billabongAFS/windlogger_shield/README.md

# widlogger_shield
This is the branch for the current version : v2.0.1

This board contains the functions to convert the signals from sensors to signals for the microcontroller.

This board is design to be plug in the digital board, but you can use it with an arduino uno or mega.

Comment are insert in the schematic, open the kicad project or the pdf export to read those.

## BLOCK DIAGRAM
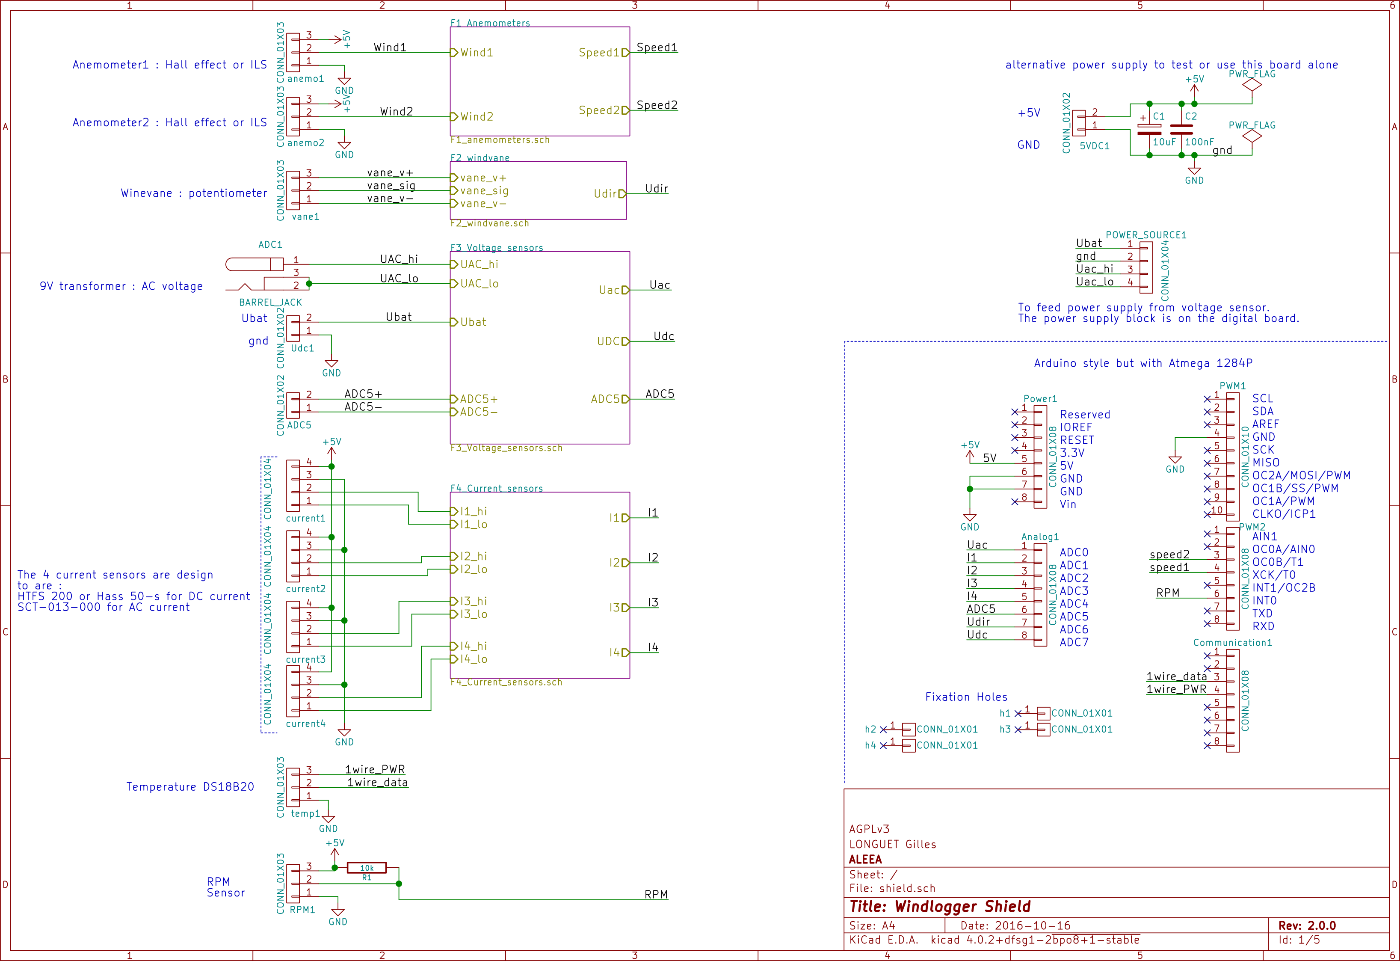
[picture p1: shield_bd.png]
windlogger shield block diagram


## RENDER PREVIEW
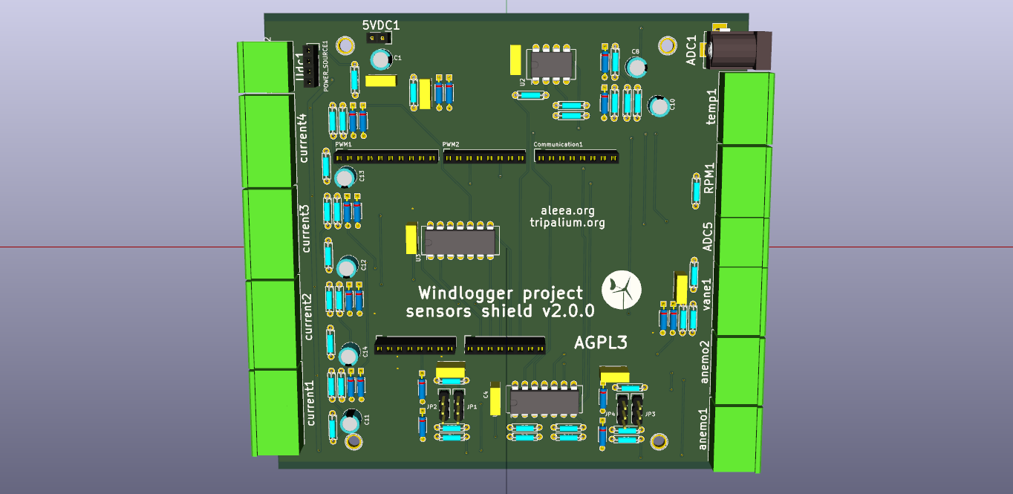
[picture p2: shield_pcb.png]
windlogger shield render preview


## Todo list
- chose the componants
- update the BOM
- route the board
- test
