billabongAFS/windlogger_shield/PDF/shield.pdf

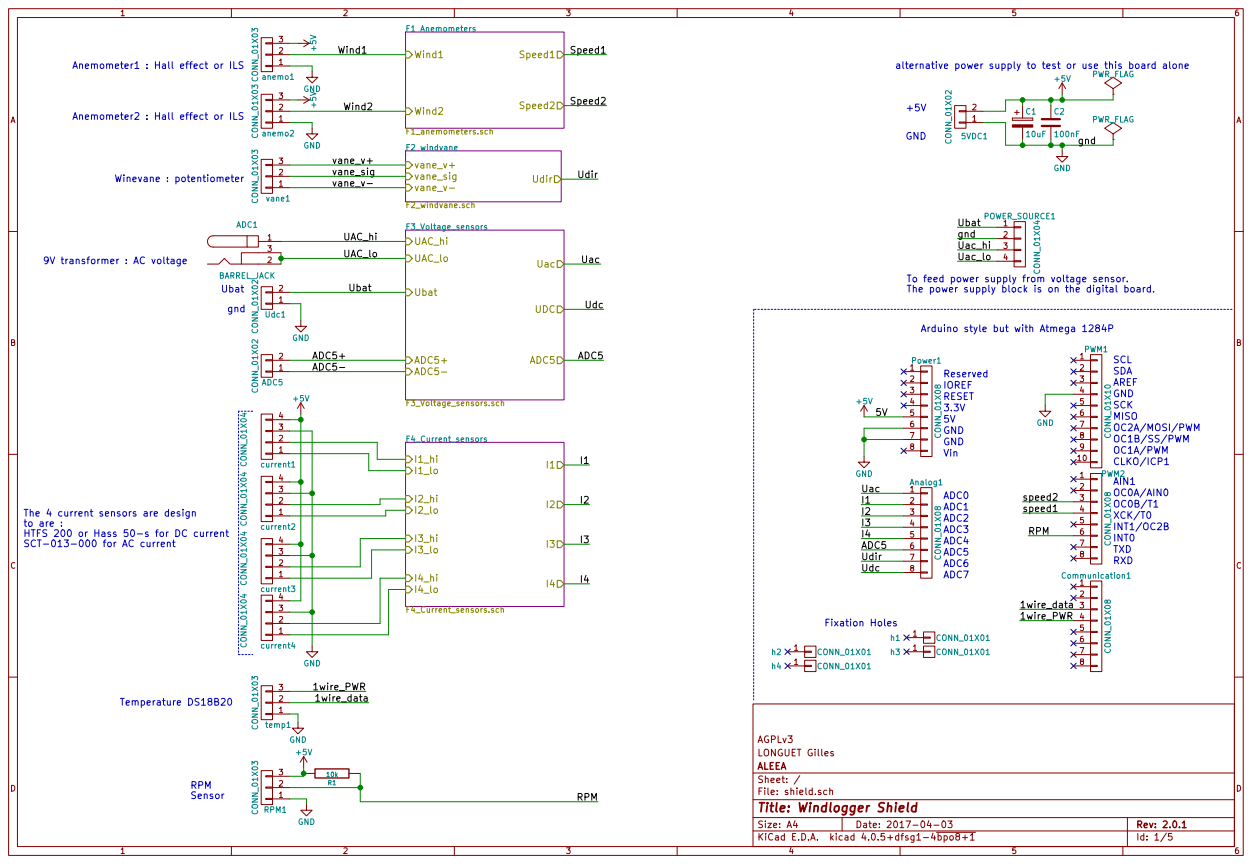
[picture p13: page 1]

Anemometer1 : Hall effect or ILS

vane_v- vane_v+ Anemometer2 : Hall effect or ILS

To feed power supply from voltage sensor.
The power supply block is on the digital board.

Vin Reserved Arduino style but with Atmega 1284P

+5V The 4 current sensors are design

to are : HTFS 200 or Hass 50-s for DC current

1wire_data

LONGUET Gilles AGPLv3

File: shield.sch Sheet: / ALEEA

Id: 1/5 Title: Windlogger Shield

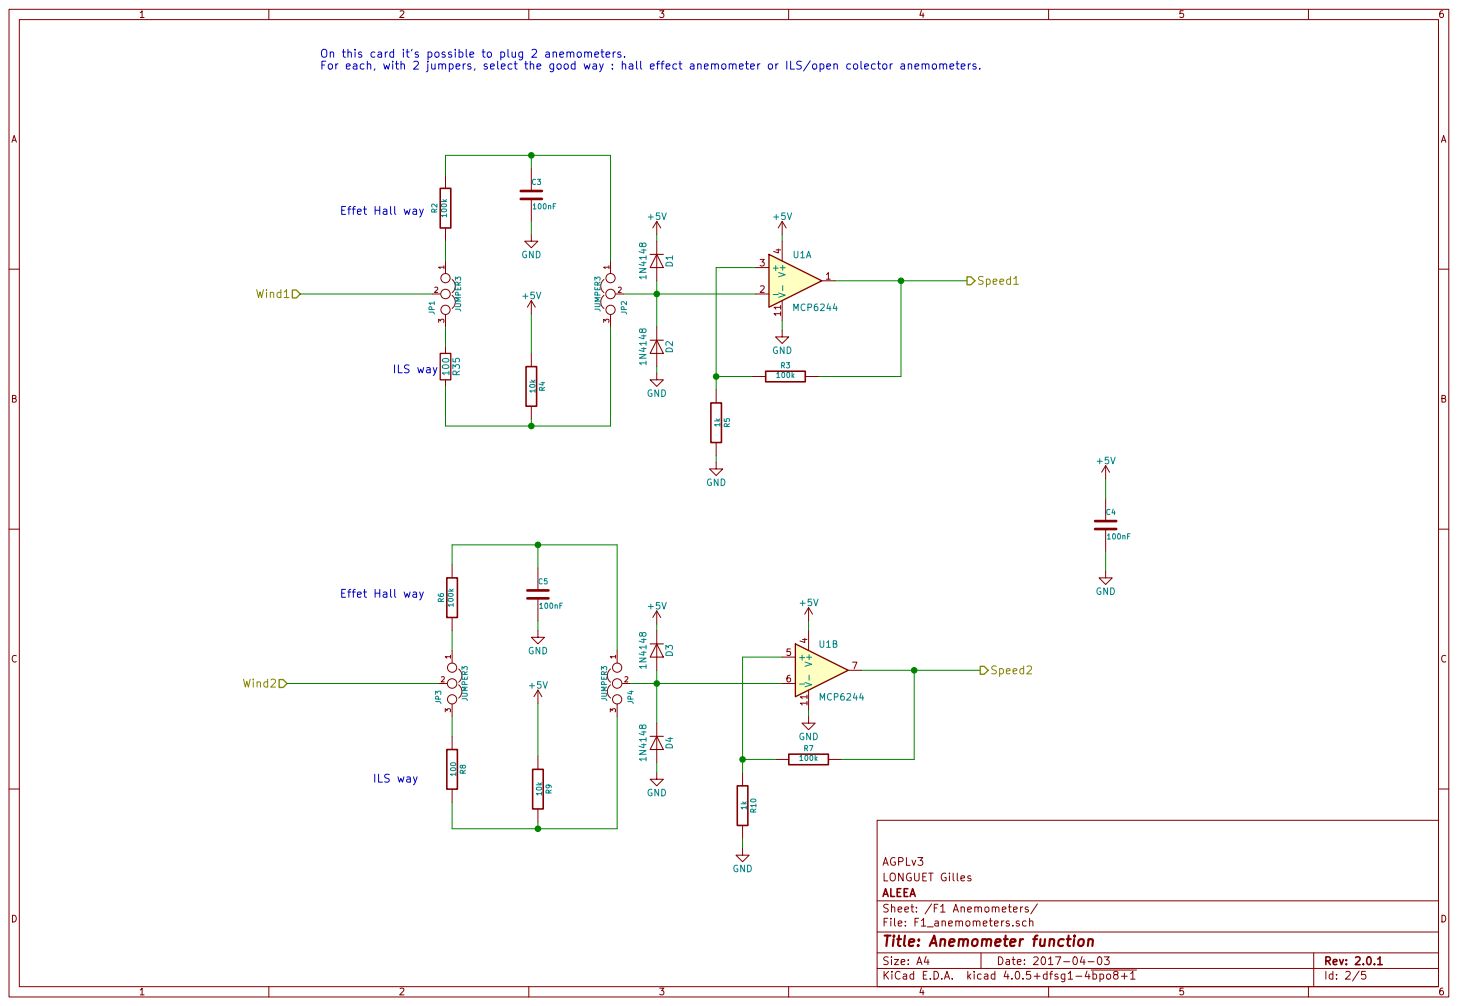
[picture p14: page 2]

On this card it's possible to plug 2 anemometers.

File: F1_anemometers.sch Sheet: /F1 Anemometers/ ALEEA

Id: 2/5 Title: Anemometer function

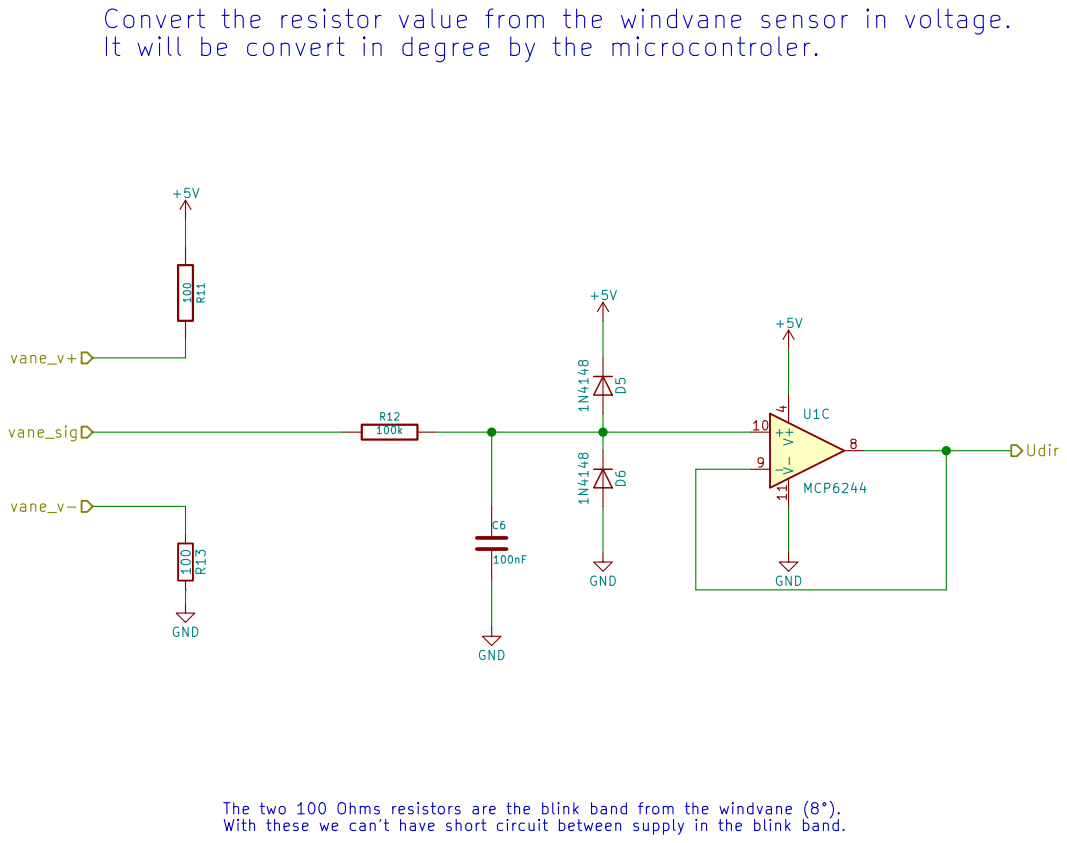
[picture p15: page 3]

Convert the resistor value from the windvane sensor in voltage.
It will be convert in degree by the microcontroler.

The two 100 Ohms resistors are the blink band from the windvane (8°).

File: F2_windvane.sch Sheet: /F2 windvane/ ALEEA

Id: 3/5 Title: Windvane function

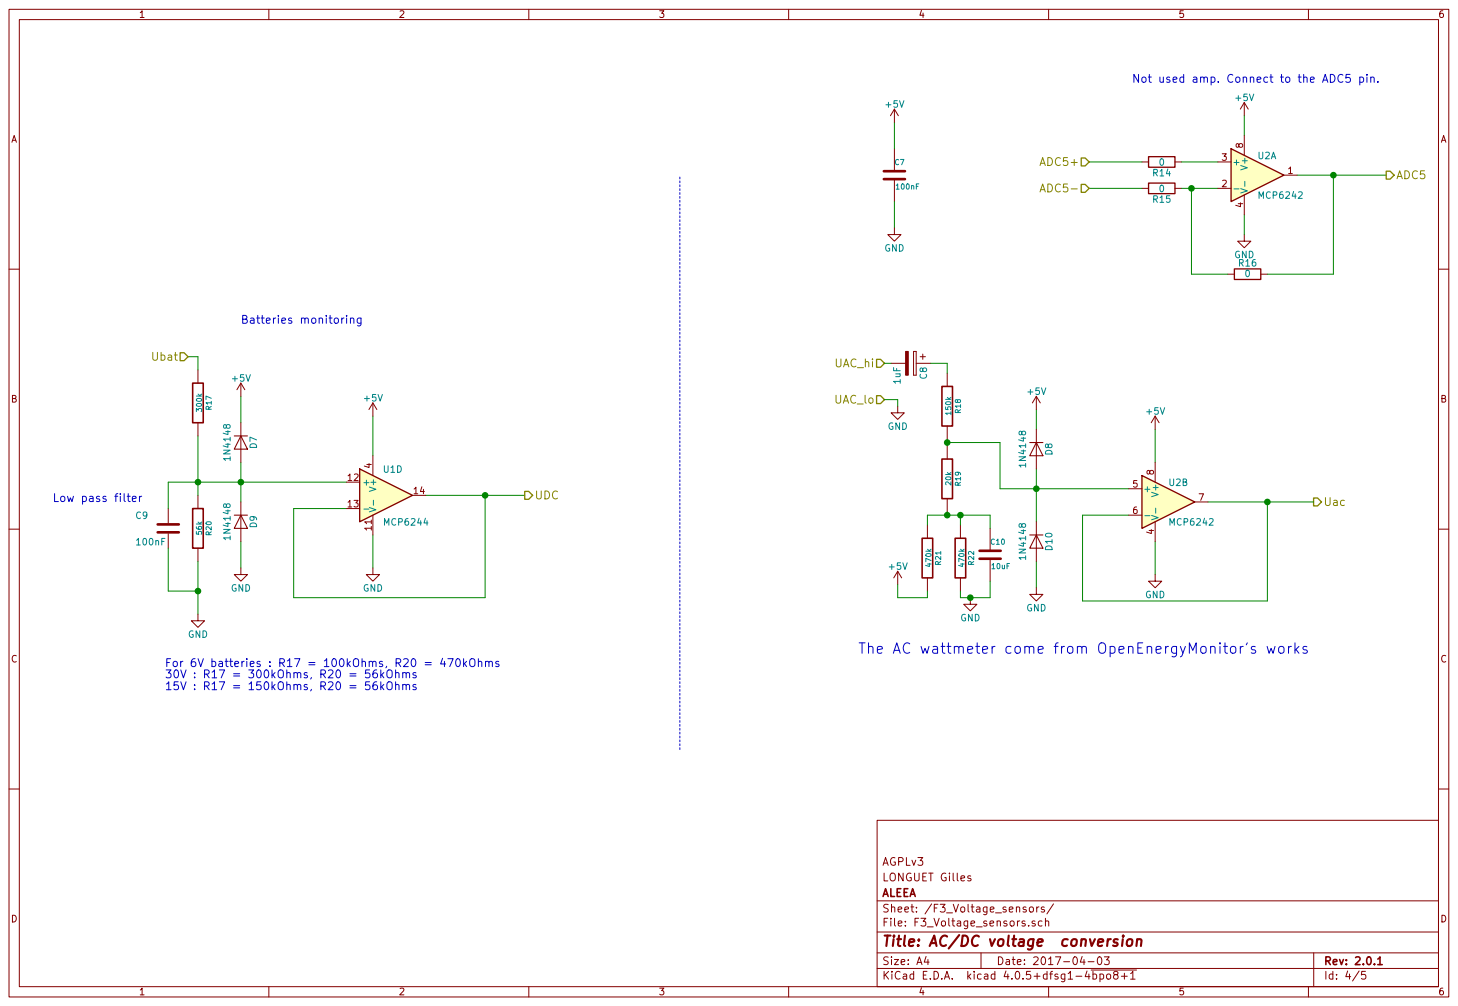
[picture p16: page 4]

Not used amp. Connect to the ADC5 pin.

100nF The AC wattmeter come from OpenEnergyMonitor's works 150k R18 +5V

File: F3_Voltage_sensors.sch
Id: 4/5 Title: AC/DC voltage conversion

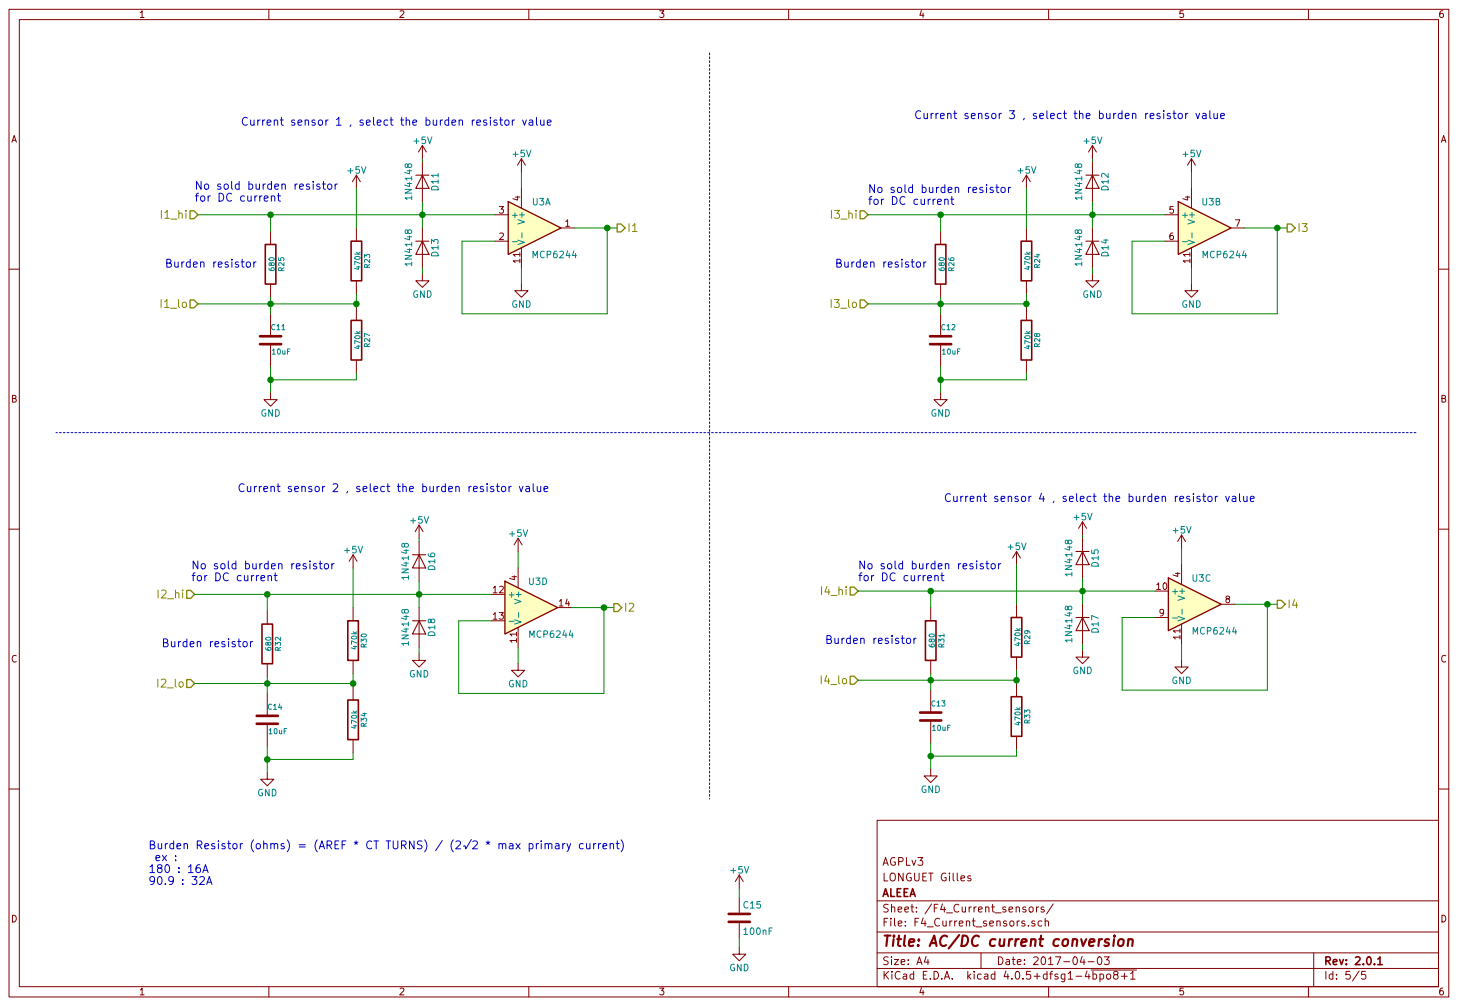
[picture p17: page 5]

for DC current No sold burden resistor

No sold burden resistor
for DC current

Current sensor 2 , select the burden resistor value

Current sensor 4 , select the burden resistor value

Burden Resistor (ohms) = (AREF * CT TURNS) / (22 * max primary current)

File: F4_Current_sensors.sch
Id: 5/5 Title: AC/DC current conversion
