billabongAFS/windlogger_shield/kicad/F1_anemometers.sch

## KiCad design kicad/F1_anemometers.sch (2018-02-20)

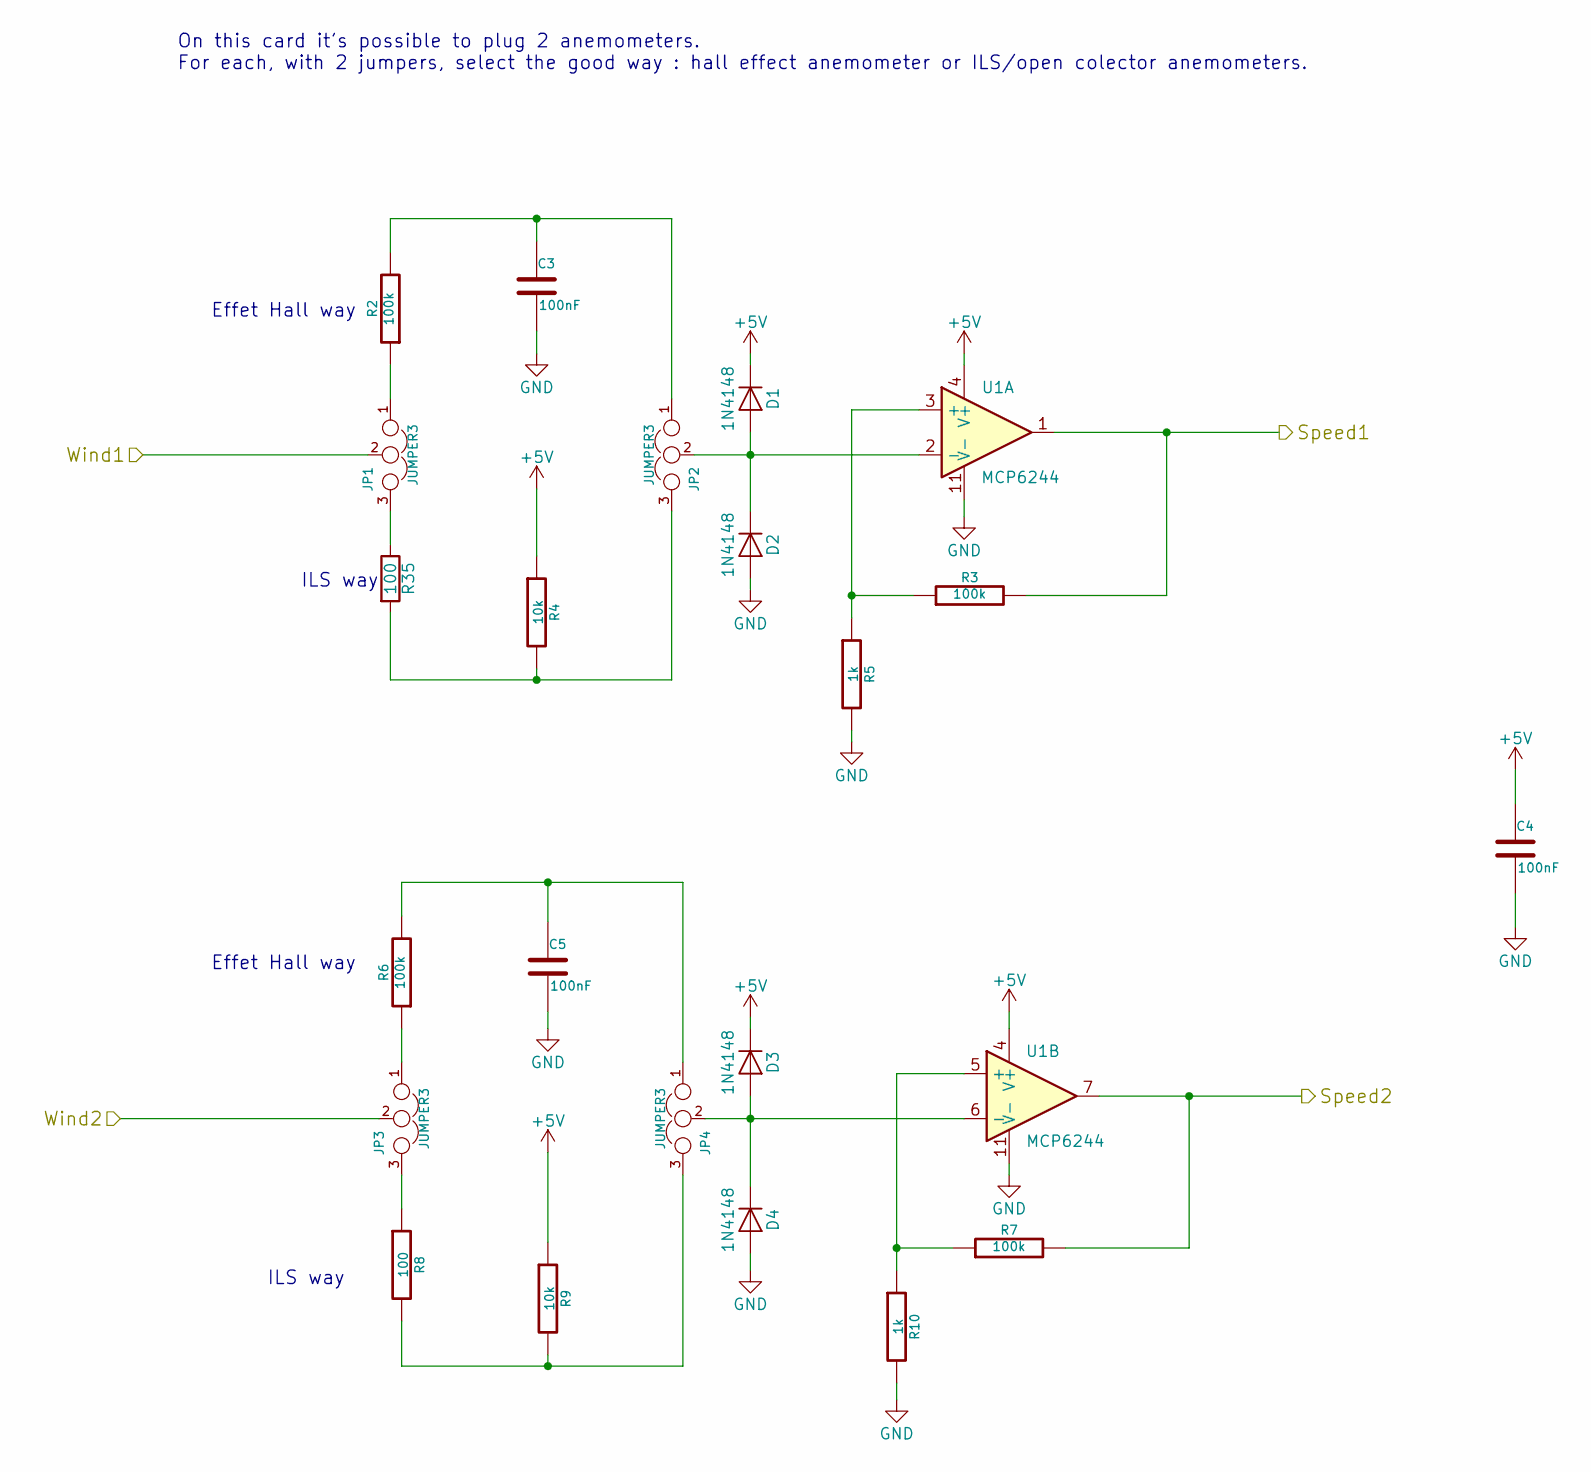
[picture p18: schematic F1_anemometers.sch]

Parts:
C3, C4, C5: 100nF; C_Rect_L7_W2.5_P5
D1, D2, D3, D4: 1N4148; DO-35
JP1, JP2, JP3, JP4: JUMPER3; Pin_Header_Straight_1x03
R2, R3, R6, R7: 100k; R4-LARGE_PADS; Tolerance 1%
R4, R9: 10k; R4-LARGE_PADS; Tolerance 1%
R5, R10: 1k; R4-LARGE_PADS; Tolerance 1%
R8, R35: 100; R4-LARGE_PADS
U1: MCP6244; DIP-14_W7.62mm_LongPads

Connections:
+5V: C4.1, D1.1 (K), D3.1 (K), R4.1, R9.1, U1.4 (V+)
GND: C3.2, C4.2, C5.2, D2.2 (A), D4.2 (A), R5.2, R10.2, U1.11 (V-)
unnamed: C3.1, JP2.1, R2.2
unnamed: C5.1, JP4.1, R6.2
unnamed: D1.2 (A), D2.1 (K), JP2.2, U1.2 (-)
unnamed: D3.2 (A), D4.1 (K), JP4.2, U1.6 (-)
unnamed: JP1.1, R2.1
unnamed: JP1.3, R35.1
unnamed: JP2.3, R4.2, R35.2
unnamed: JP3.1, R6.1
unnamed: JP3.3, R8.1
unnamed: JP4.3, R8.2, R9.2
unnamed: R3.1, R5.1, U1.3 (+)
unnamed: R7.1, R10.1, U1.5 (+)
Speed1: R3.2, U1.1
Speed2: R7.2, U1.7
Wind1: JP1.2
Wind2: JP3.2

Notes on the sheet:
Effet Hall way
ILS way
On this card it's possible to plug 2 anemometers. For each, with 2 jumpers, select the good way : hall effect anemometer or ILS/open colector anemometers.
