billabongAFS/windlogger_shield/kicad/F3_Voltage_sensors.sch

## KiCad design kicad/F3_Voltage_sensors.sch (2018-02-20)

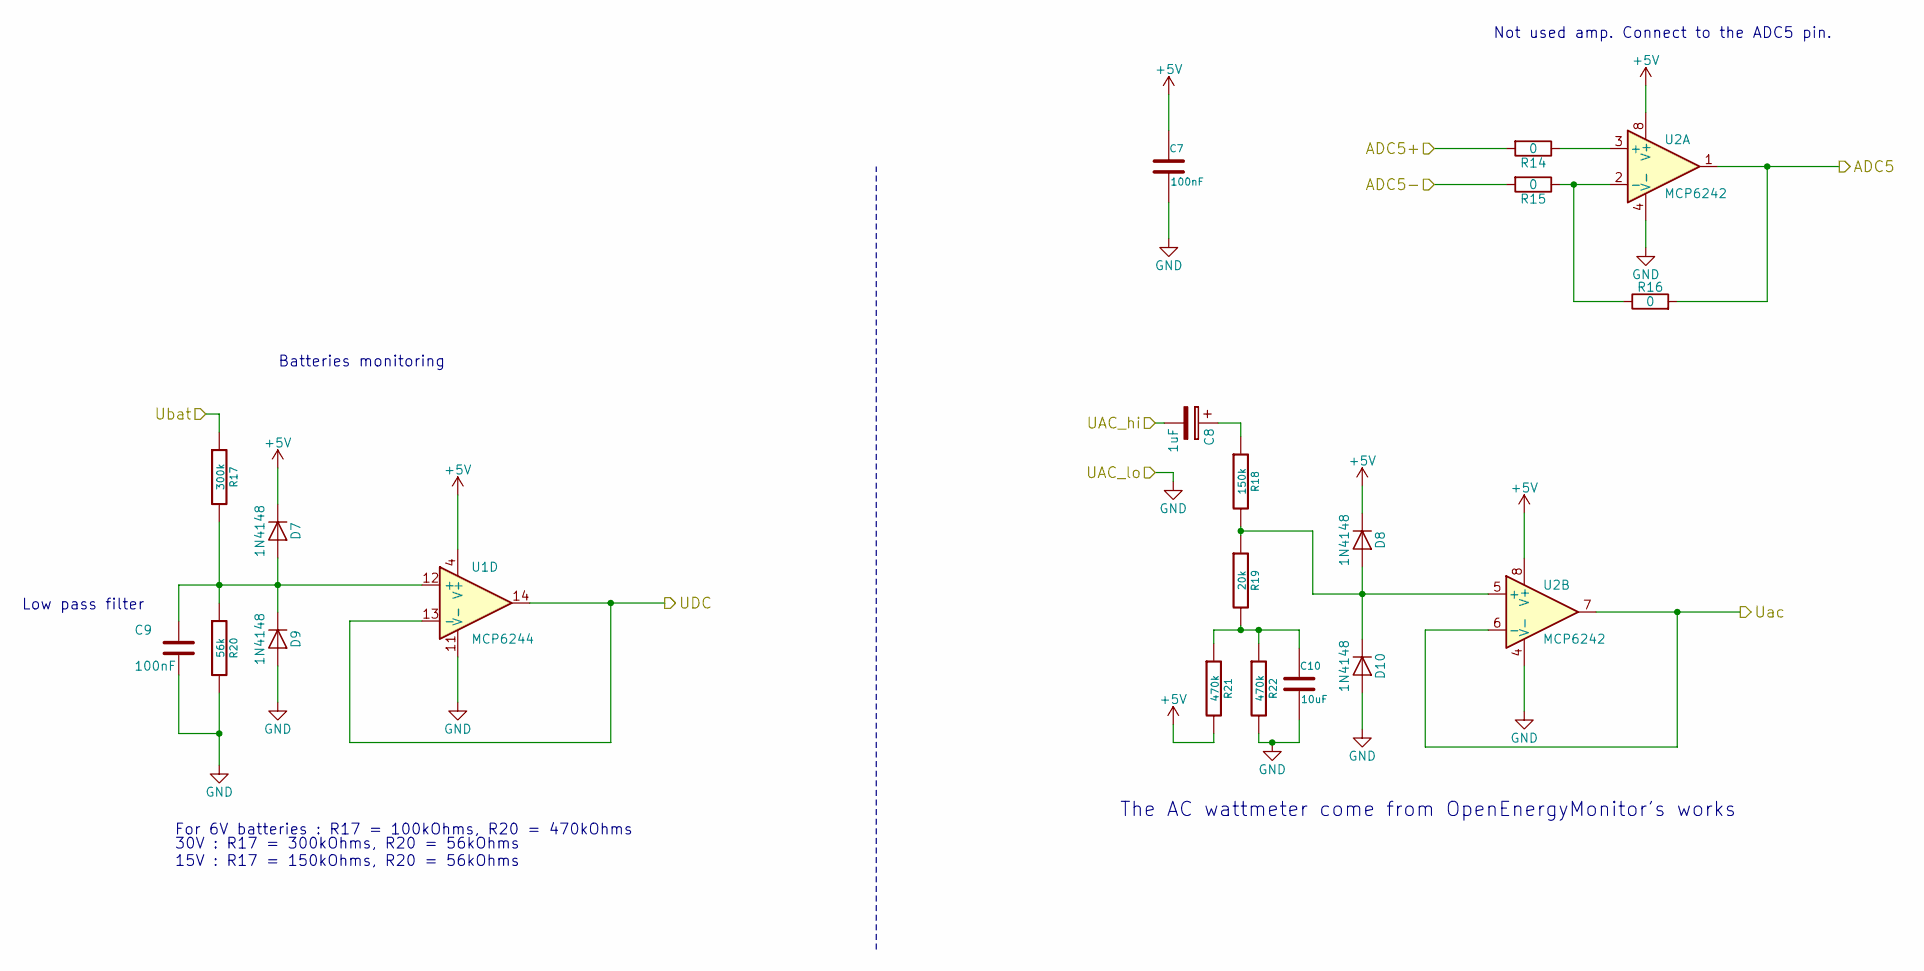
[picture p20: schematic F3_Voltage_sensors.sch]

Parts:
C7, C9: 100nF; C_Rect_L7_W2.5_P5
C8: 1uF; C_Radial_D5_L6_P2.5
C10: 10uF; C_Radial_D5_L6_P2.5
D7, D8, D9, D10: 1N4148; DO-35
R14, R15, R16: 0; R4-LARGE_PADS
R17: 300k; R4-LARGE_PADS; Tolerance 1%
R18: 150k; R4-LARGE_PADS; Tolerance 1%
R19: 20k; R4-LARGE_PADS; Tolerance 1%
R20: 56k; R4-LARGE_PADS; Tolerance 1%
R21, R22: 470k; R4-LARGE_PADS; Tolerance 1%
U1: MCP6244; DIP-14_W7.62mm_LongPads
U2: MCP6242; DIP-8_W7.62mm_LongPads

Connections:
+5V: C7.1, D7.1 (K), D8.1 (K), R21.2, U1.4 (V+), U2.8 (V+)
ADC5: R16.2, U2.1
ADC5+: R14.2
ADC5-: R15.2
GND: C7.2, C9.2, C10.2, D9.2 (A), D10.2 (A), R20.2, R22.2, U1.11 (V-), U2.4 (V-)
unnamed: C8.1, R18.1
unnamed: C9.1, D7.2 (A), D9.1 (K), R17.2, R20.1, U1.12 (+)
unnamed: C10.1, R19.2, R21.1, R22.1
unnamed: D8.2 (A), D10.1 (K), R18.2, R19.1, U2.5 (+)
unnamed: R14.1, U2.3 (+)
unnamed: R15.1, R16.1, U2.2 (-)
UAC_hi: C8.2
UDC: U1.13 (-), U1.14
Uac: U2.6 (-), U2.7
Ubat: R17.1

Notes on the sheet:
The AC wattmeter come from OpenEnergyMonitor's works
Batteries monitoring
Low pass filter
Not used amp. Connect to the ADC5 pin.
For 6V batteries : R17 = 100kOhms, R20 = 470kOhms
30V : R17 = 300kOhms, R20 = 56kOhms 15V : R17 = 150kOhms, R20 = 56kOhms
