billabongAFS/windlogger_shield/kicad/F4_Current_sensors.sch

## KiCad design kicad/F4_Current_sensors.sch (2018-02-20)

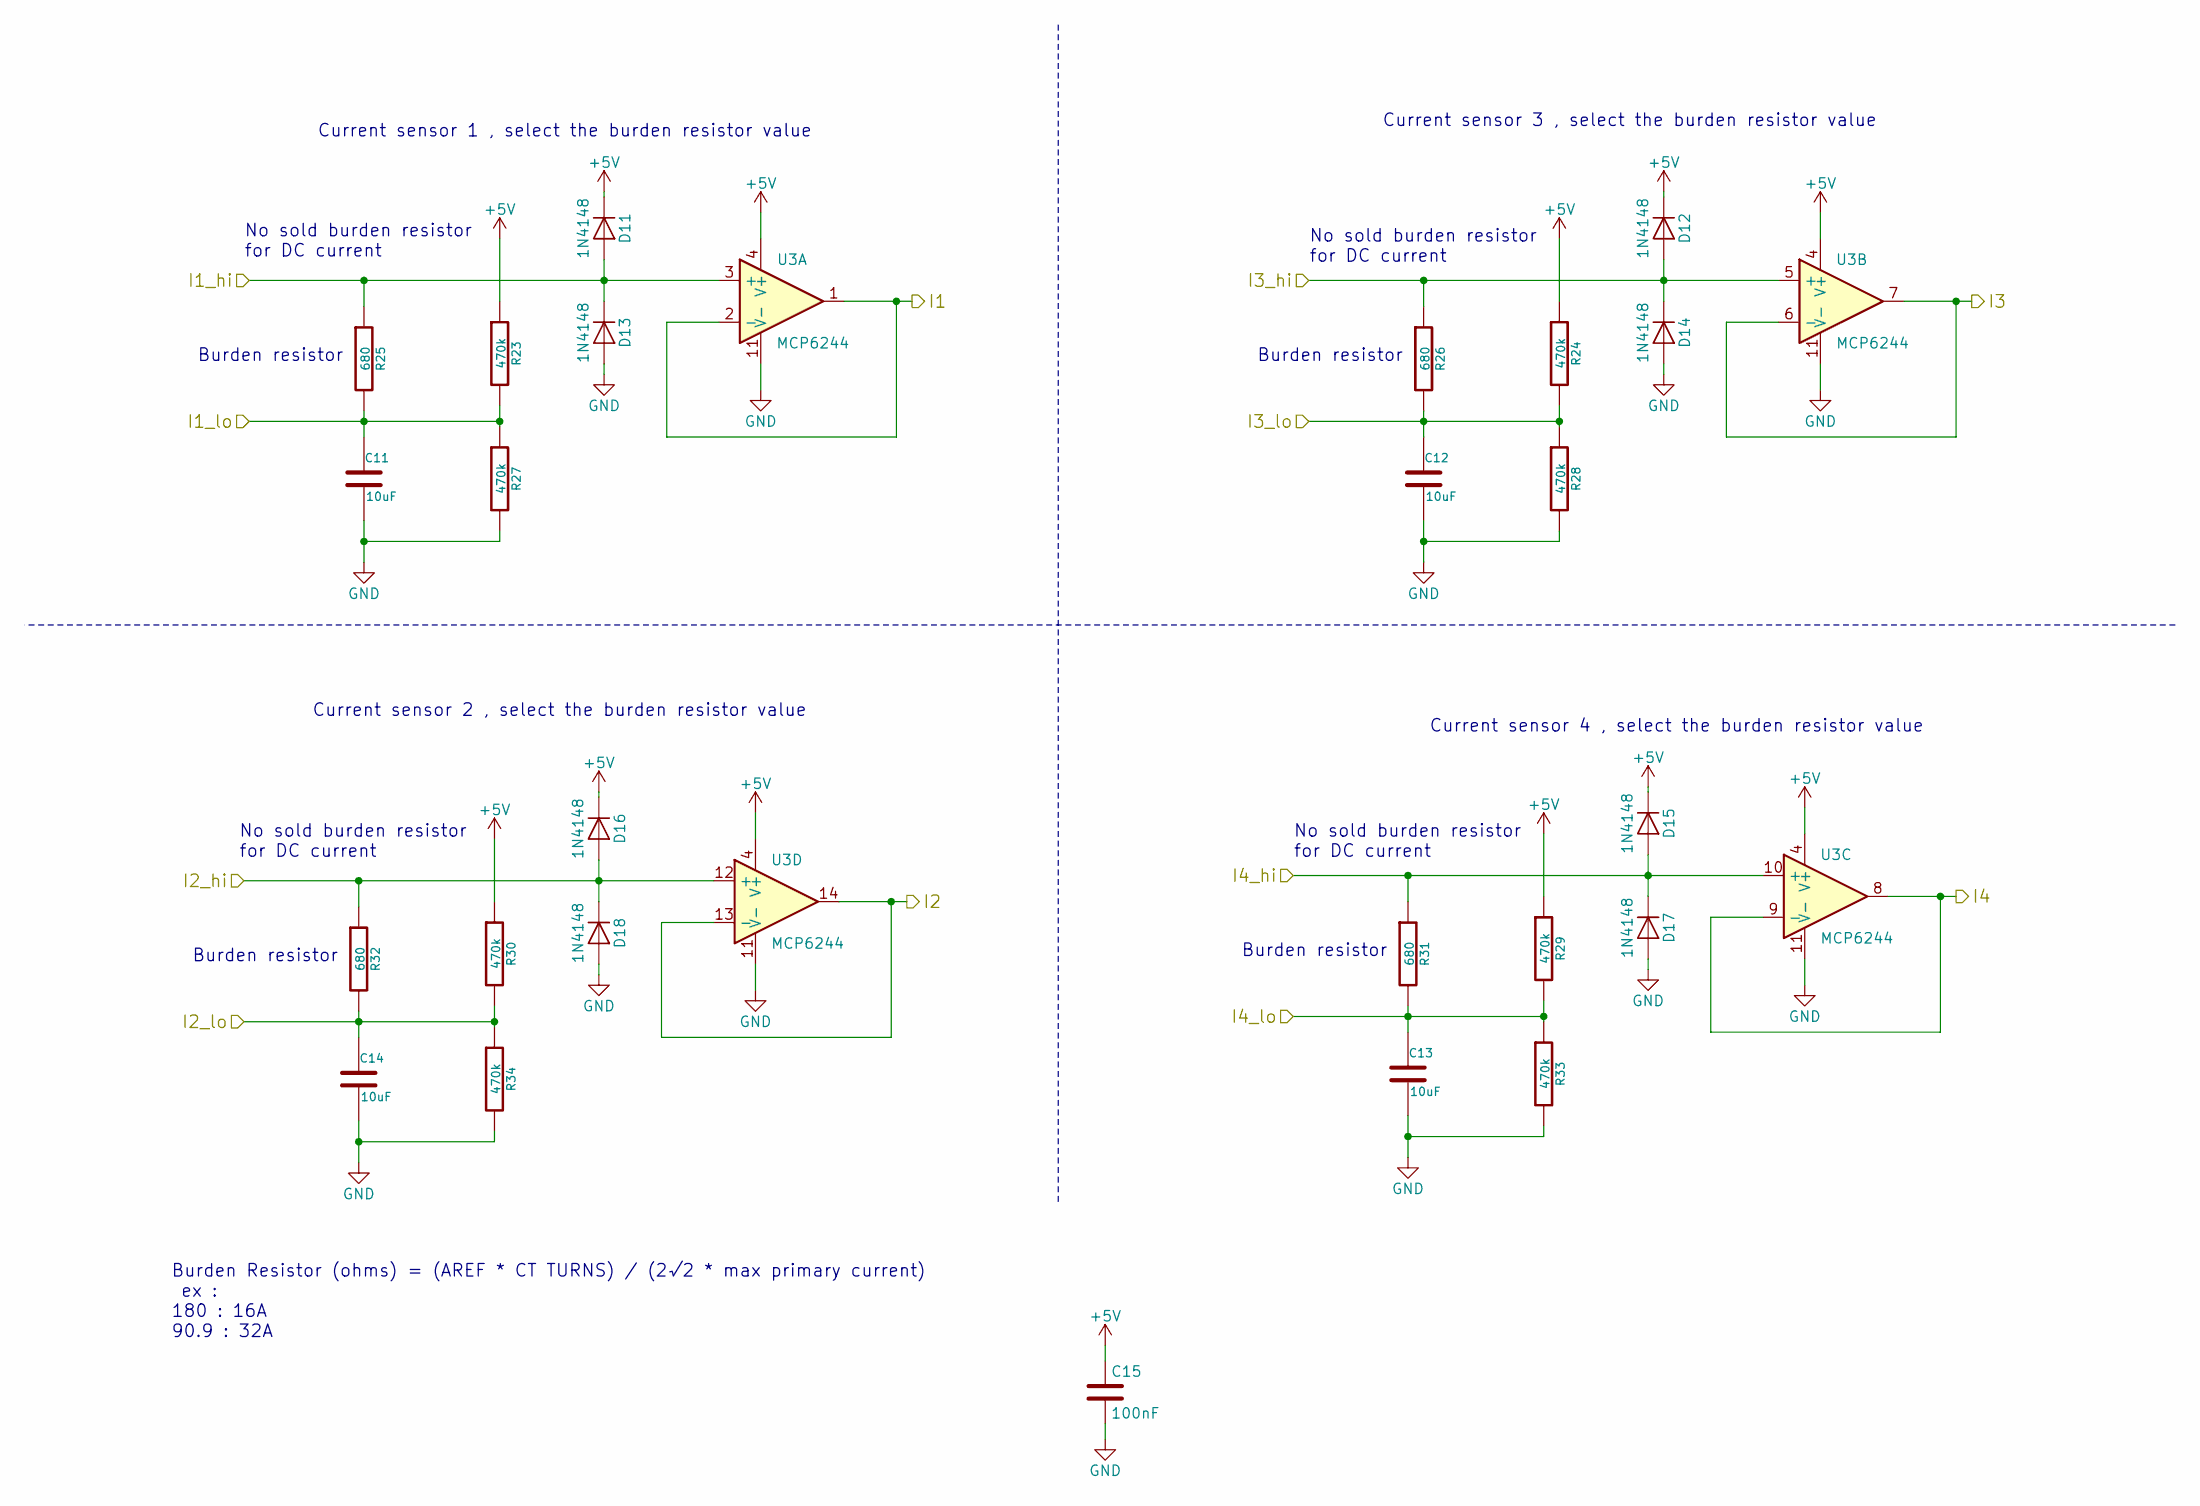
[picture p21: schematic F4_Current_sensors.sch]

Parts:
C11, C12, C13, C14: 10uF; C_Radial_D5_L6_P2.5
C15: 100nF; C_Rect_L7_W2.5_P5
D11, D12, D13, D14, D15, D16, D17, D18: 1N4148; DO-35
R23, R24, R27, R28, R29, R30, R33, R34: 470k; R4-LARGE_PADS; Tolerance 1%
R25, R26, R31, R32: 680; R4-LARGE_PADS; Tolerance 1%
U3: MCP6244; DIP-14_W7.62mm_LongPads

Connections:
+5V: C15.1, D11.1 (K), D12.1 (K), D15.1 (K), D16.1 (K), R23.1, R24.1, R29.1, R30.1, U3.4 (V+)
GND: C11.2, C12.2, C13.2, C14.2, C15.2, D13.2 (A), D14.2 (A), D17.2 (A), D18.2 (A), R27.2, R28.2, R33.2, R34.2, U3.11 (V-)
I1: U3.1, U3.2 (-)
I1_hi: D11.2 (A), D13.1 (K), R25.1, U3.3 (+)
I1_lo: C11.1, R23.2, R25.2, R27.1
I2: U3.13 (-), U3.14
I2_hi: D16.2 (A), D18.1 (K), R32.1, U3.12 (+)
I2_lo: C14.1, R30.2, R32.2, R34.1
I3: U3.6 (-), U3.7
I3_hi: D12.2 (A), D14.1 (K), R26.1, U3.5 (+)
I3_lo: C12.1, R24.2, R26.2, R28.1
I4: U3.8, U3.9 (-)
I4_hi: D15.2 (A), D17.1 (K), R31.1, U3.10 (+)
I4_lo: C13.1, R29.2, R31.2, R33.1

Notes on the sheet:
Burden resistor
Current sensor 1 , select the burden resistor value
Current sensor 3 , select the burden resistor value
Current sensor 2 , select the burden resistor value
Current sensor 4 , select the burden resistor value
Burden Resistor (ohms) = (AREF * CT TURNS) / (2√2 * max primary current) ex : 180 : 16A 90.9 : 32A
No sold burden resistor for DC current
