billabongAFS/windlogger_shield/kicad/F5_temperature.sch

## KiCad design kicad/F5_temperature.sch (2018-02-20)

Schematic: F5_temperature.sch

Parts:
C601: 100nF; C_Radial_D5_L6_P2.5
NTC601: 2.2k; R4; Tolerance 5%
R601, R603, R604, R605, R606: 10k; R4; Tolerance 1%
R602: 10k; R4
U502, U601: LMV358; DIP-8_W7.62mm_LongPads

Notes on the sheet:
NTCLE100E3222JB0
Convert the ntc resitor in voltage
I will change it by a pt1000 resistor or a ds1820 one wire sensor.
