billabongAFS/windlogger_shield/(commit log)

2018-01-26 .gitignore update for kicad and ltstpice used
2018-02-09 initial commit from old repo
    [F1_anemometers.sch, F2_windvane.sch, F3_Voltage_sensors.sch, F4_Current_sensors.sch, F5_temperature.sch, shield.sch]
